josevas72/rf-cc1101-esp32/README.md

# RF CC1101 + ESP32 — placa, firmware ESPHome y caja 3D

Emisor/receptor de radiofrecuencia a **433,92 MHz** con un ESP32 y el módulo **CC1101**
(E07-M1101D), pensado para Home Assistant mediante **ESPHome**. Sirve para controlar por RF
persianas, luces, enchufes o ventiladores con mando, y para escuchar el mando original y mantener
sincronizado el estado.

El repositorio incluye todo lo necesario para reproducirlo: la **placa (PCB)** en KiCad con sus
archivos de fabricación, el **firmware** (plantillas ESPHome) y una **caja imprimible** en 3D.

Hay dos versiones:

- **v2 (recomendada):** placa de **39 × 18 mm** y caja de **48 × 21 × 36,5 mm**. Ver abajo.
- **v1:** la placa original de 58 × 53 mm, con cabecera I2C y caja vertical. Se puede
  descargar tal cual en la etiqueta [`v1.0`](https://github.com/josevas72/rf-cc1101-esp32/releases/tag/v1.0).

<p align="center">
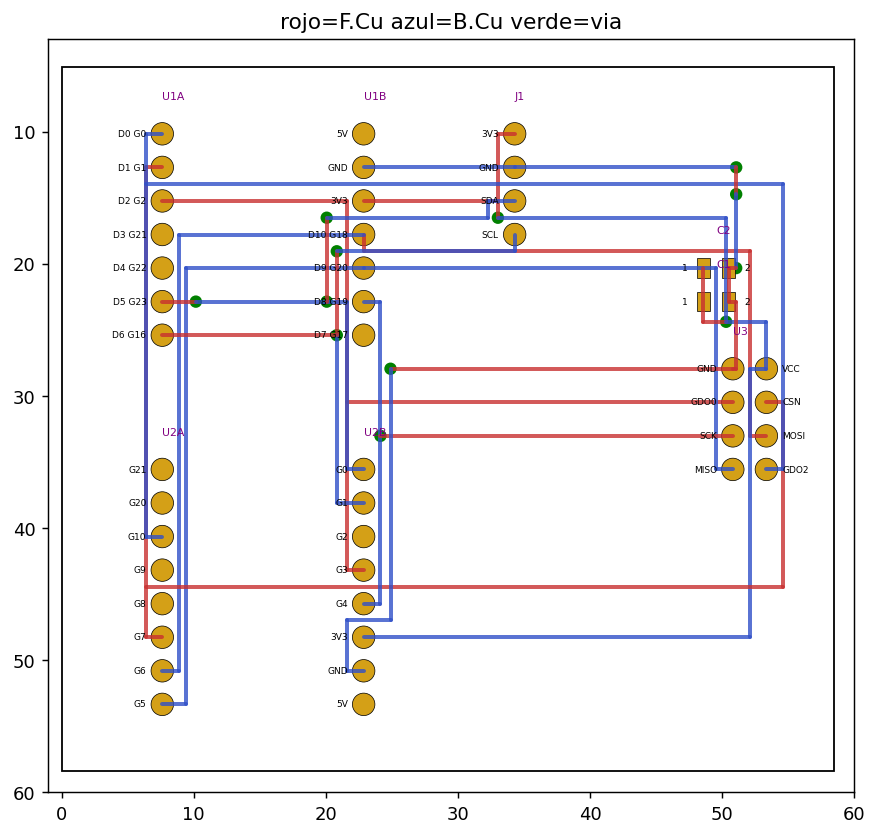
[picture p1: docs/img/pcb_rutado.png]
Rutado de la PCB
  
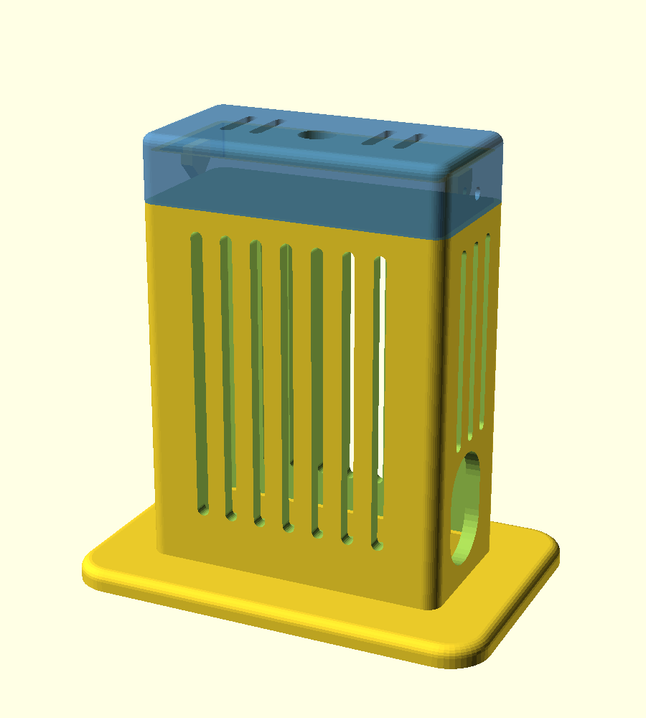
[picture p2: docs/img/caja_v4_montada.png]
Caja 3D montada
  
</p>

## Versión 2: placa pequeña

<p align="center">
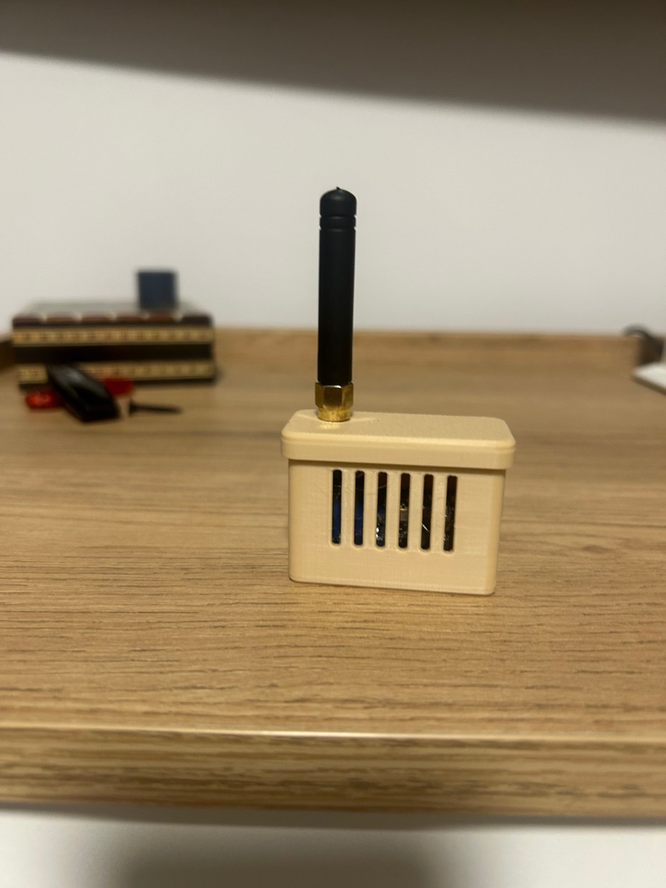
[picture p3: docs/img/v2_frontal.jpg]
Caja v2 con la placa dentro y la antena por la tapa
  
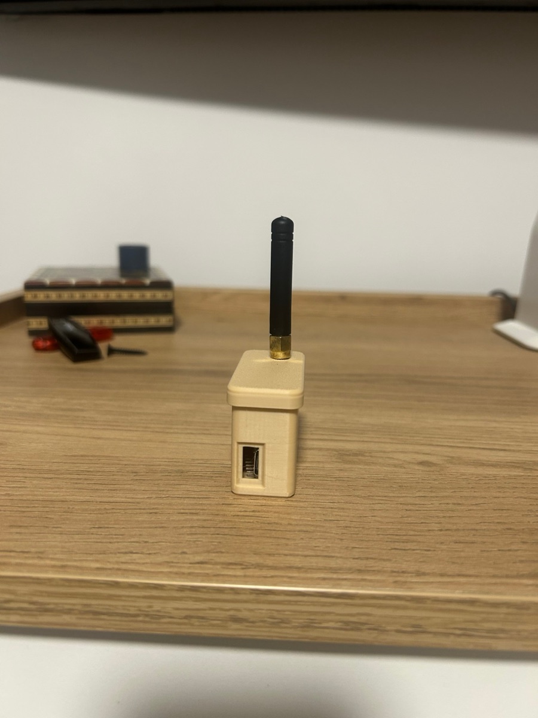
[picture p4: docs/img/v2_lateral_usb.jpg]
Lateral de la caja v2 con el hueco del USB-C
  
</p>
<p align="center">
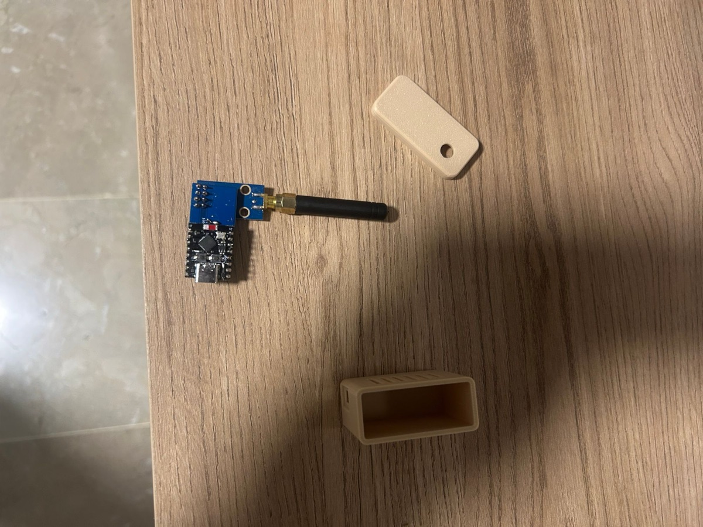
[picture p5: docs/img/v2_piezas.jpg]
Placa v2 montada con el SuperMini y el CC1101, caja y tapa
  
</p>

### Qué cambia respecto a la v1

- Placa de **39,1 × 18,3 mm** (la v1 medía 58,4 × 53,3 mm), 2 capas, 1,6 mm, masa en las dos caras y una sola vía.
- Vista de frente, de izquierda a derecha: **ESP32-C3 SuperMini** en horizontal con el **USB-C por el lateral
  izquierdo**, un **electrolítico de 100 µF** entre 3V3 y GND en medio (pad cuadrado = +) y el zócalo 2×4 del
  **E07-M1101D** con la **antena hacia arriba**.
- Sin GDO2 (emite y recibe por GDO0), sin cabecera I2C y sin los SMD de 10 µF y 100 nF.
- **Los GPIO son los mismos que en la v1**, así que el firmware es prácticamente el mismo.
- Hay otra versión de la misma placa para **XIAO ESP32-C6** (38,1 × 18,3 mm, 2 zócalos 1×7).
  Está diseñada y pasa el DRC, pero **no se ha fabricado todavía**.

| Señal | C3 SuperMini | XIAO ESP32-C6 | E07-M1101D |
|---|---|---|---|
| SCK | GPIO4 | D8 (GPIO19) | 5 |
| MISO | GPIO5 | D9 (GPIO20) | 7 |
| MOSI | GPIO6 | D10 (GPIO18) | 6 |
| CS | GPIO7 | D1 (GPIO1) | 4 |
| GDO0 | GPIO3 | D2 (GPIO2) | 3 |
| 3V3 / GND | 3V3 / GND | 3V3 / GND | 2 / 1 |

<p align="center">
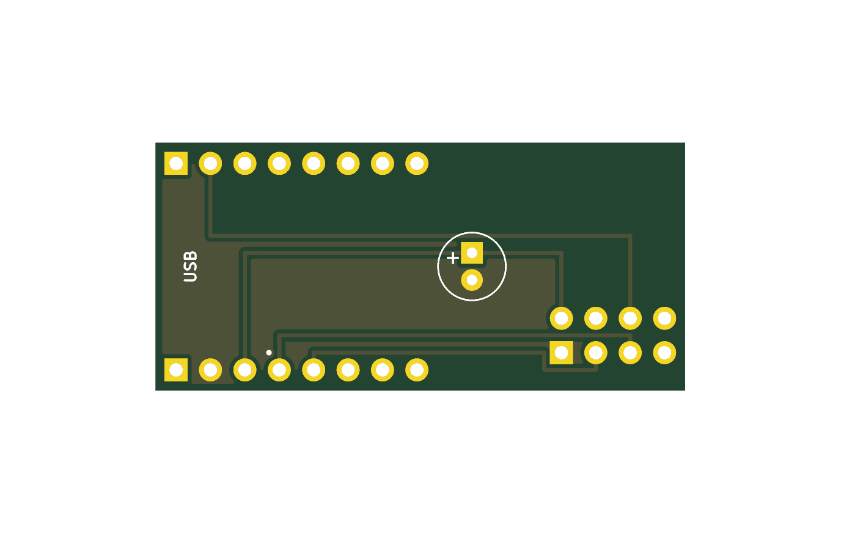
[picture p6: hardware/pcb-v2/img/supermini_delantera.png]
PCB v2, cara delantera
  
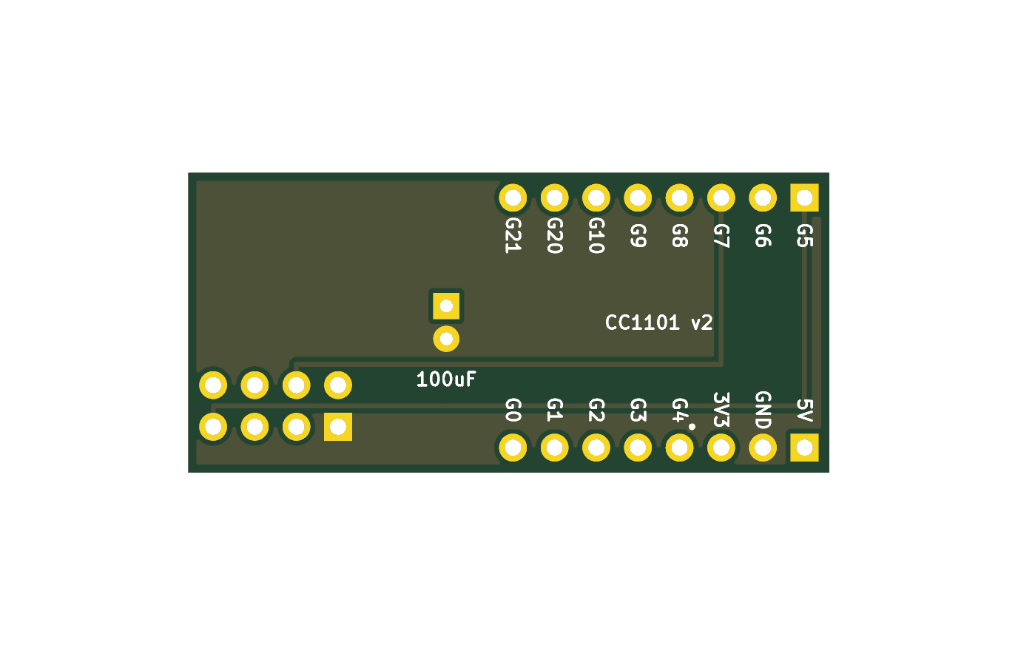
[picture p7: hardware/pcb-v2/img/supermini_trasera.png]
PCB v2, cara trasera
  
</p>

### Materiales (v2)

- ESP32-C3 SuperMini y 2 zócalos hembra 1×8 de 2,54 mm.
- Módulo CC1101 **E07-M1101D** (433 MHz) con antena SMA recta (la de las fotos mide 47 mm) y 1 zócalo hembra 2×4.
- Condensador electrolítico de **100 µF** (Ø5 mm, paso 2 mm). Cualquier altura: no tiene nada encima.

### Fabricación

- SuperMini: sube `hardware/pcb-v2/fabricacion/rf_cc1101_v2_D_PCBWay.zip` a PCBWay o JLCPCB
  (2 capas, 1,6 mm, HASL, agujero mínimo 0,4 mm).
- XIAO C6 (sin probar): `rf_cc1101_v2_XIAO_PCBWay.zip`.
- Proyectos KiCad: `hardware/pcb-v2/kicad/` (SuperMini) y `hardware/pcb-v2/kicad-xiao/`. Si lo modificas,
  pulsa **B** para rellenar las zonas de masa antes del DRC.
- `hardware/pcb-v2/generador/generador_placa_v2.py` es el script en Python que generó el diseño
  (`python3 generador_placa_v2.py <carpeta> D` o `X`). Opcional.

### Caja (v2)

`hardware/caja-v2/` contiene el diseño en **OpenSCAD** (paramétrico) y los STL listos para imprimir.

- Exterior **48 × 21 × 36,5 mm** con la tapa. Interior para un conjunto de 43 × 16 × 32 mm con 0,5 mm de holgura.
- La placa va de pie. La **tuerca del SMA aprieta el módulo contra la tapa** y a la vez cierra la caja: no hace falta
  ningún tornillo.
- La tapa abraza la caja por fuera (ajuste 0,05 mm, probado en PLA). Si te queda floja o dura, cambia `ajuste`
  en el `.scad`.
- Hueco del USB-C con rebaje para la funda del cable, ranuras de ventilación, «RF» grabado en el frente y
  huecos para 4 pies de goma.
- La caja se imprime boca arriba y la tapa boca abajo, las dos sin soportes.
- En el `.scad`, `part = "caja" | "tapa" | "ambas" | "montaje"`.

<p align="center">
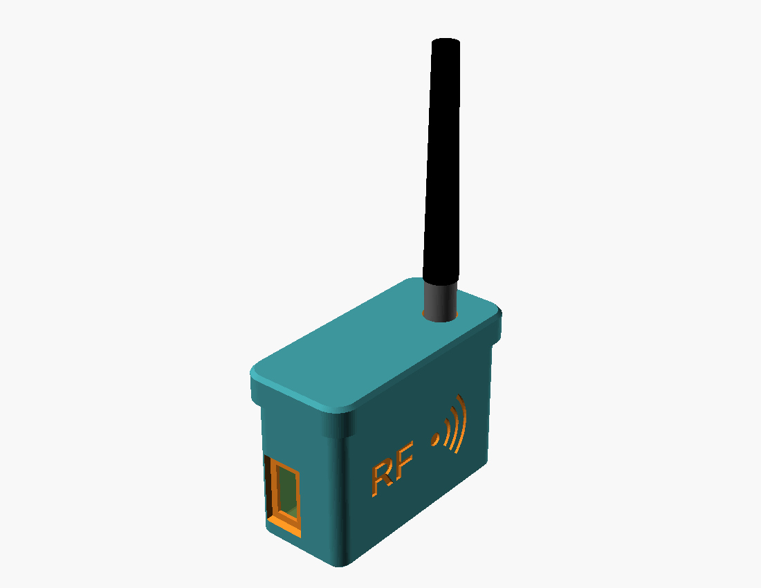
[picture p8: hardware/caja-v2/img/vista_montaje.png]
Vista de montaje de la caja v2 en OpenSCAD
  
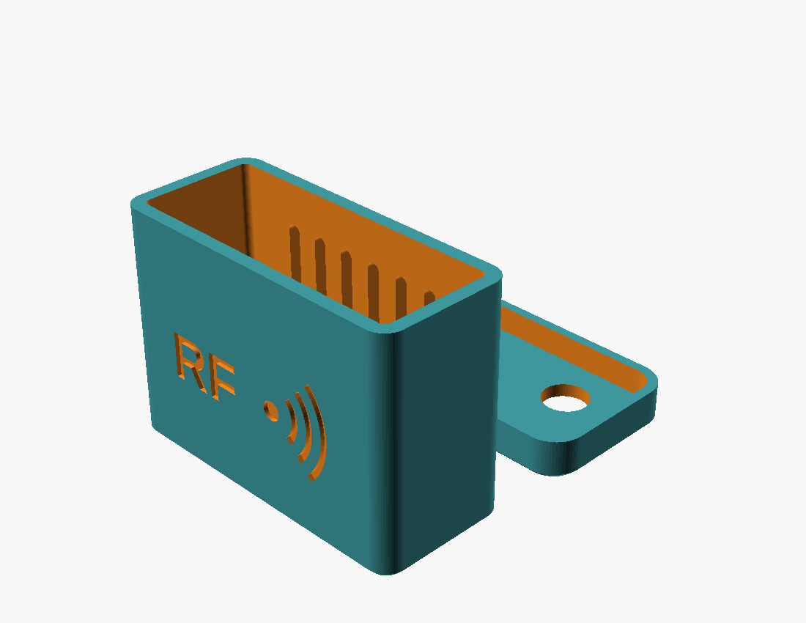
[picture p9: hardware/caja-v2/img/vista_ambas.png]
Caja y tapa v2 en OpenSCAD
  
</p>

### Firmware (v2)

- **SuperMini:** `firmware/esphome/rf-cc1101-v2-c3-supermini.yaml`. Es la plantilla de la v1 sin I2C,
  con la potencia WiFi a 8,5 dBm y un ejemplo nuevo de **ventilador de techo con 6 velocidades** (entidad
  `fan`). Los códigos de los ejemplos son **falsos**: captura los tuyos con `docs/capturar_codigos_rf.md`.
- **XIAO C6:** sirve `firmware/esphome/rf-cc1101-xiao-c6.yaml` de la v1. Borra el bloque `i2c:` si no
  lo usas.

### Lecciones de la v2

1. La WiFi del SuperMini es floja: cerca de un punto de acceso funciona bien, pero a −80 dBm pierde órdenes.
   Colócalo cerca de un punto de acceso o usa el XIAO.
2. Bajar la potencia WiFi a 8,5 dBm hace que la antena del CC1101 se sature menos.
3. Mide el conjunto montado, con el SMA puesto, antes de diseñar la caja: los planos del módulo no bastan.

---

## Versión 1: placa original

## Fotos

<p align="center">
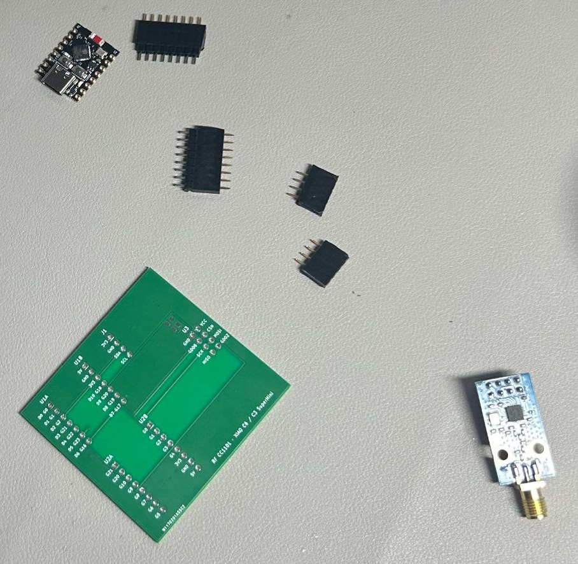
[picture p10: docs/img/componentes_antes_de_soldar.jpg]
Placa recibida y componentes antes de soldar
  
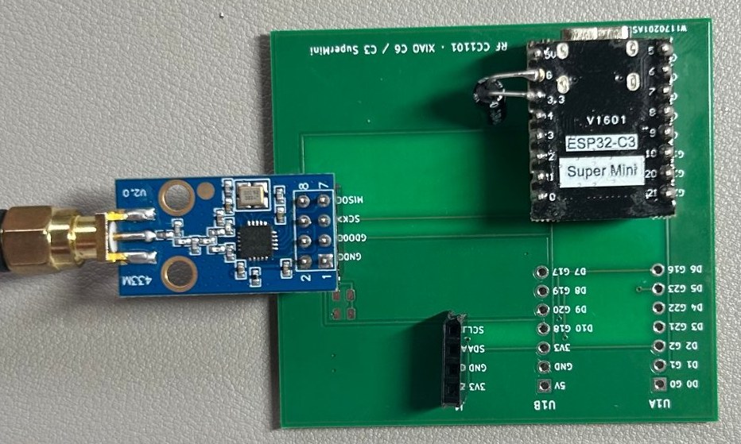
[picture p11: docs/img/placa_prueba_encaje.jpg]
Prueba de encaje del SuperMini y del módulo CC1101
  
</p>
<p align="center">
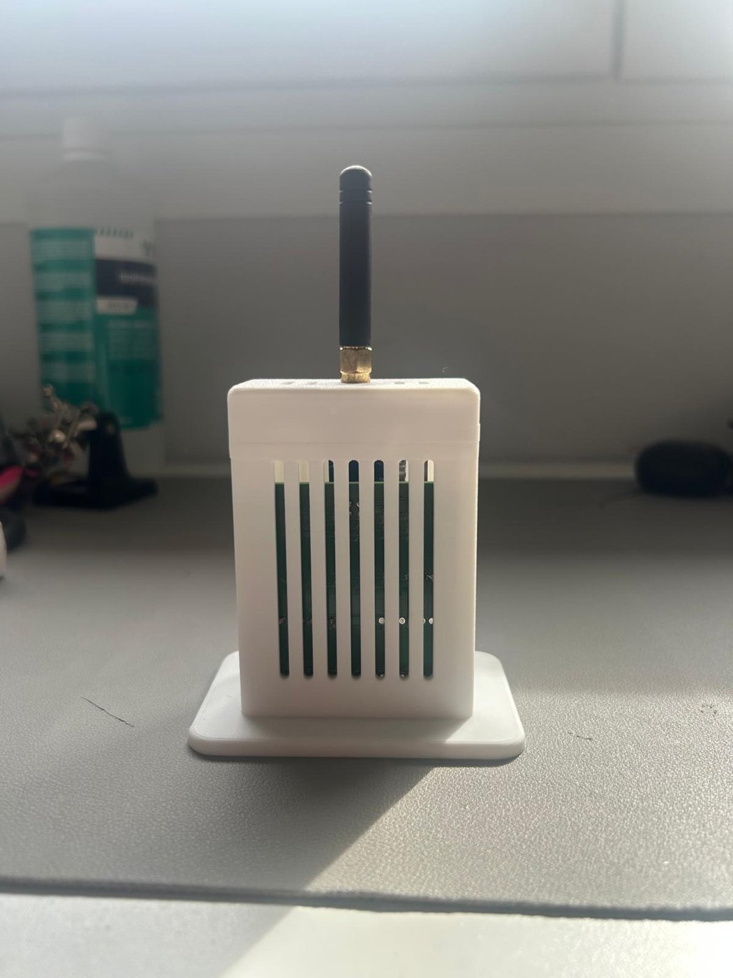
[picture p12: docs/img/caja_prototipo_actual.jpg]
Caja impresa con la placa dentro y la antena fuera
  
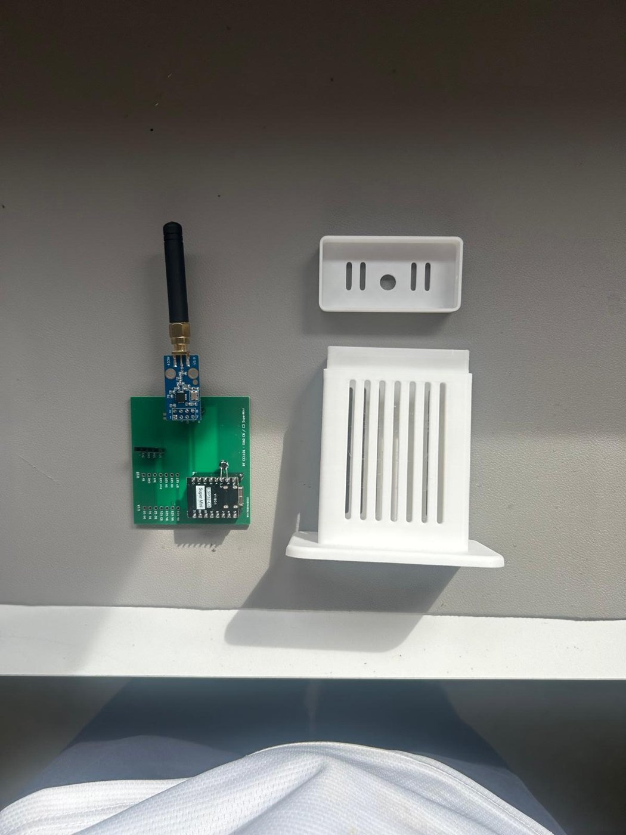
[picture p13: docs/img/piezas_caja_placa.jpg]
Caja, tapa, placa y módulo CC1101 antes de montar
  
</p>

*Arriba: la placa tal como llega de fábrica con los zócalos, el SuperMini y el módulo antes de soldar,
y una primera prueba de encaje. Abajo: la caja impresa con la placa dentro (se ve por las ranuras) y la antena saliendo por la tapa, y las piezas antes de montar.*

## Características

- Placa de 2 capas (58,4 × 53,3 mm) con zócalos para **ESP32-C3 SuperMini** o **XIAO ESP32-C6**
  (se monta uno solo; ver estado de pruebas) y zócalo 2×4 para el módulo **E07-M1101D**.
- Cabecera I2C para un sensor de temperatura (AHT20, BME280, SHT4x…).
- Firmware con el componente nativo `cc1101` de ESPHome, emisión y recepción por un solo pin
  (GDO0) y filtros contra el ruido del receptor.
- **WiFi por portal cautivo**: no hay claves en el código; el dispositivo crea su propia red y
  eliges tu WiFi desde el móvil.
- Caja vertical con peana, tapa tipo caja de zapatos, ventilación, hueco para USB y orificio para
  la antena.

## Estructura del repositorio

```
hardware/
  pcb-v2/             v2: kicad/ (SuperMini), kicad-xiao/, fabricacion/, generador/, img/
  caja-v2/            v2: caja_rf_pequeno.scad, stl/ (caja y tapa), img/
  pcb/                v1:
    kicad/            proyecto KiCad (.kicad_pro, .kicad_pcb, .kicad_sch)
    fabricacion/      ZIP listo para PCBWay/JLCPCB (Gerbers + taladros)
    BOM.csv           lista de materiales
    pcb_rutado.png    vista del rutado
    extras/           script Python que generó el diseño inicial (opcional)
  caja/               v1: caja_rf_cc1101_v4.stl (caja y tapa, listo para imprimir)
firmware/
  esphome/            rf-cc1101-v2-c3-supermini.yaml (v2), rf-cc1101-c3-supermini.yaml y
                      rf-cc1101-xiao-c6.yaml (v1) y secrets.example.yaml
docs/
  capturar_codigos_rf.md   cómo capturar los códigos de un mando
  img/
```

## Hardware

### Conexiones

| Señal | XIAO ESP32-C6 | ESP32-C3 SuperMini |
|---|---|---|
| SCK | GPIO19 (D8) | GPIO4 |
| MISO | GPIO20 (D9) | GPIO5 |
| MOSI | GPIO18 (D10) | GPIO6 |
| CS (CSN) | GPIO1 (D1) | GPIO7 |
| GDO0 | GPIO2 (D2) | GPIO3 |
| GDO2 | GPIO0 (D0) | GPIO10 |
| I2C SDA | GPIO23 (D5) | GPIO0 |
| I2C SCL | GPIO16 (D6) | GPIO1 |

Orden de pines del zócalo del módulo (como el NRF24L01): 1 GND, 2 VCC, 3 GDO0, 4 CSN, 5 SCK,
6 MOSI, 7 MISO, 8 GDO2. El pin 1 lleva el pad cuadrado.

> **Nota XIAO ESP32-C6:** GPIO3 controla el conmutador de antena interno y no sale a ningún pin,
> por eso GDO2 va a GPIO0.

### Lista de materiales

- ESP32-C3 SuperMini **o** XIAO ESP32-C6.
- Módulo CC1101 **E07-M1101D** (433 MHz) con antena SMA.
- Zócalos hembra 2,54 mm: 2 × 1×8 (SuperMini) o 2 × 1×7 (XIAO) y 1 × 2×4.
- Cabecera macho 1×4 para el sensor I2C.
- Condensadores 0805: 10 µF (C1) y 100 nF (C2). Recomendable además un electrolítico de
  100 µF entre 3V3 y GND.
- 2 tornillos M2 × 4 mm autorroscantes (tapa de la caja).

### Fabricación de la PCB

1. Abre `hardware/pcb/kicad/rf_cc1101.kicad_pro` con KiCad 8 o superior.
2. Pulsa **B** para rellenar las zonas de masa y ejecuta el DRC.
3. Para pedirla, sube `hardware/pcb/fabricacion/rf_cc1101_PCBWay.zip` (9 Gerbers y el archivo de
   taladros `.txt`) a tu fabricante. Opciones: 2 capas, 1,6 mm, HASL.

Estado de las pruebas:

- **ESP32-C3 SuperMini:** probado en la PCB, funcionando en producción.
- **XIAO ESP32-C6:** probado y funcionando en producción en un prototipo **cableado a mano**.
  En esta PCB se ha verificado la continuidad de todos los GPIO entre el ESP32-C6 y el CC1101,
  pero **la PCB aún no se ha montado con el XIAO**.

## Firmware (ESPHome)

Necesita **ESPHome 2026.9 o superior**.

1. Elige el archivo de tu placa: `rf-cc1101-c3-supermini.yaml` o `rf-cc1101-xiao-c6.yaml`
   (solo cambian los pines y la placa) y cópialo a tu carpeta de ESPHome.
2. Rellena la sección `substitutions:` del principio (nombre, nombre amistoso, red y **contraseña
   del punto de acceso**). Opcionalmente genera una clave para la API. Compila y graba por USB:
   `esphome run rf-cc1101-c3-supermini.yaml`.
3. Conéctate a la red **RF-CC1101 Config** (se abre el portal; si no, entra en
   `http://192.168.33.1`), elige tu WiFi e introduce la clave.
4. Home Assistant detectará el dispositivo. Si más adelante cambia el router, la red de
   configuración reaparece sola; también puedes mantener 10 s el botón BOOT para restablecer el
   WiFi.

Decisiones de configuración que funcionan bien:

- Pin único GDO0 para emitir y recibir con `cc1101.set_idle` / `begin_tx` / `begin_rx`.
- `filter_bandwidth: 100kHz` y `filter: 150us` en el receptor contra el ruido. Si hay ruido, prueba
  `rx_attenuation`.
- `output_power: 10dBm` en el WiFi del SuperMini para mantener la conexión estable.
- Usar GDO2 como pin de recepción separado recibía bien pero no permitía emitir; se descartó.

Al final de cada YAML hay ejemplos comentados de **persiana** y **ventilador/luz** con `xxxxx` en
lugar de códigos: son los que capturas con tu mando siguiendo `docs/capturar_codigos_rf.md`
(incluye captura de códigos raw y cómo adaptar el protocolo con ayuda de Claude).

## Caja 3D

`hardware/caja/caja_rf_cc1101_v4.stl` incluye caja y tapa, listas para imprimir (158,2 × 54,6 × 83,5 mm):

- Interior útil 54 × 25 × 80 mm, con peana ancha para que no vuelque.
- Placa de pie, antena hacia arriba por la tapa (Ø7 mm) y USB lateral.
- Ventilación por ranuras, nervio y pestañas que retienen la placa.
- Tapa que abraza el labio de la caja, fijada con 2 tornillos M2 × 4 mm laterales.

## Lecciones aprendidas

1. El ruido del receptor con antena puede saturar al ESP32 y tirar el WiFi: se resuelve con los
   filtros del CC1101 y del receptor.
2. En el XIAO ESP32-C6 no se puede usar GPIO3.
3. Los tacos de los tornillos de la tapa deben sobresalir poco para que la placa entre por arriba.

## Licencia

MIT (ver `LICENSE`). Si prefieres una licencia de hardware abierto para la PCB y la caja, por
ejemplo CERN-OHL-P o CC BY-SA 4.0, cámbiala antes de publicar.
