josevas72/rf-cc1101-esp32/hardware/pcb-v2/img/xiao_trasera.png

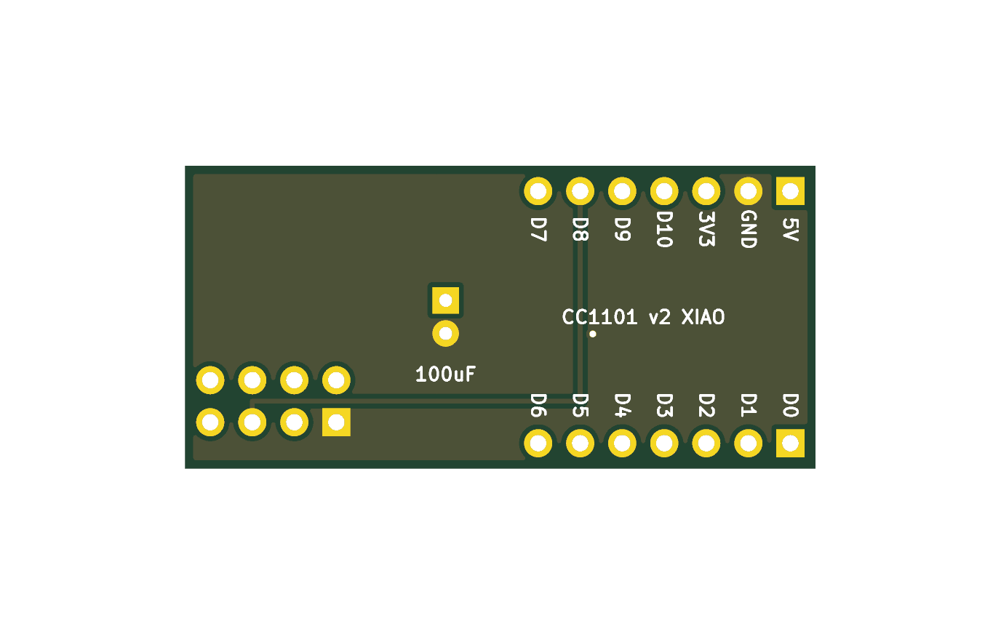
hardware/pcb-v2/img/xiao_trasera.png
