josevas72/rf-cc1101-esp32/hardware/caja-v2/stl/tapa_rf_pequeno.stl

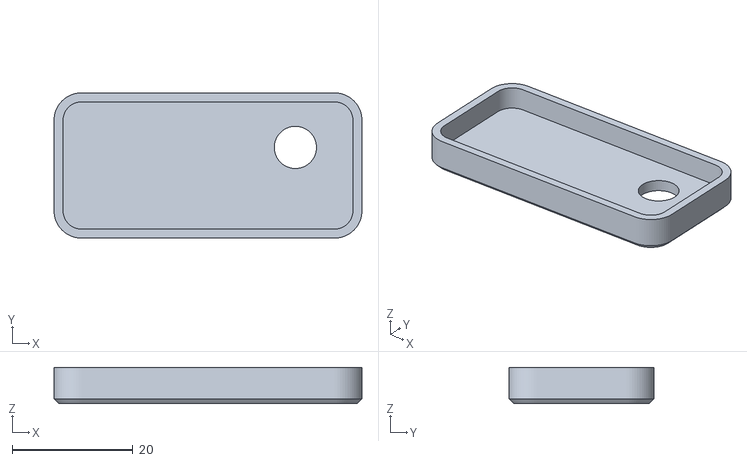
[picture p15: CAD file, 2026-11-11]
hardware/caja-v2/stl/tapa_rf_pequeno.stl
51.1 x 24.1 x 6.00
