josevas72/rf-cc1101-esp32/hardware/caja-v2/stl/caja_rf_pequeno.stl

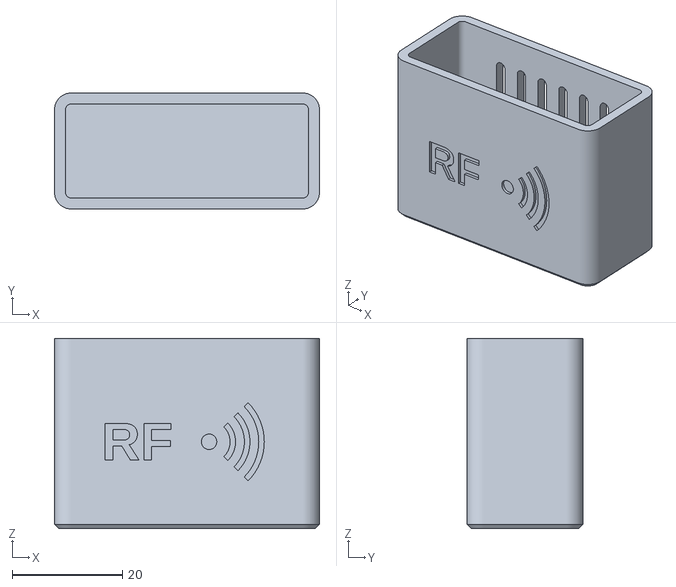
[picture p16: CAD file, 2026-11-11]
hardware/caja-v2/stl/caja_rf_pequeno.stl
48.0 x 21.0 x 34.5
