josevas72/rf-cc1101-esp32/hardware/caja/caja_rf_cc1101_v4.stl

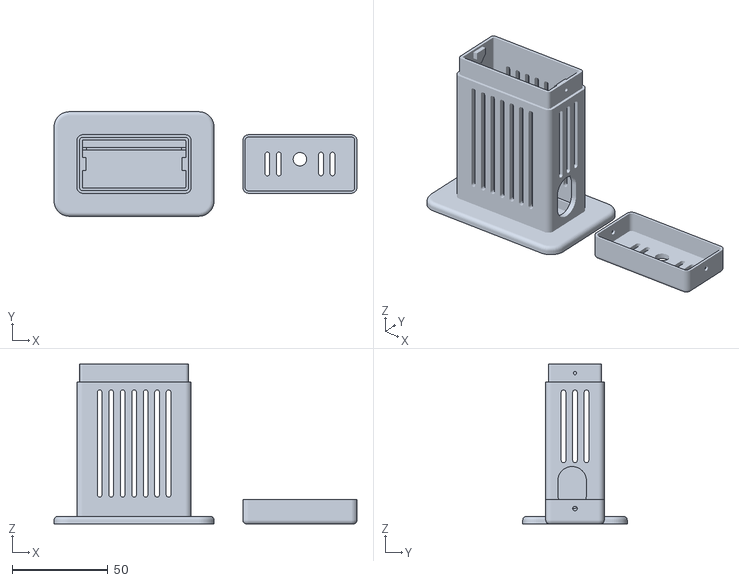
[picture p17: CAD file, 2026-10-20, an earlier design]
hardware/caja/caja_rf_cc1101_v4.stl
158.2 x 54.6 x 83.5
