josevas72/rf-cc1101-esp32/hardware/pcb-v2/kicad-xiao/rf_cc1101_v2.kicad_pcb

## KiCad design hardware/pcb-v2/kicad-xiao/rf_cc1101_v2.kicad_pcb (2026-11-11)

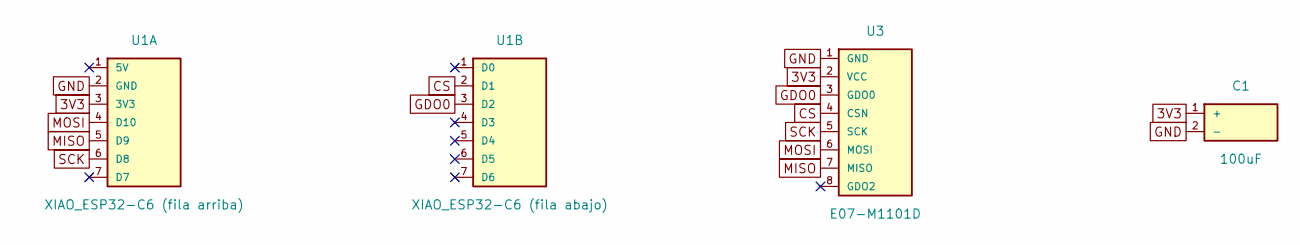
[picture p18: schematic rf_cc1101_v2.kicad_sch]

Parts:
C1: 100uF; CP_Radial_D5.0mm_P2.00mm
U1A: XIAO_ESP32-C6 (fila arriba); PinSocket_1x07_P2.54mm_Vertical
U1B: XIAO_ESP32-C6 (fila abajo); PinSocket_1x07_P2.54mm_Vertical
U3: E07-M1101D; PinSocket_2x04_P2.54mm_Vertical

Connections:
3V3: C1.1 (+), U1A.3 (3V3), U3.2 (VCC)
CS: U1B.2 (D1), U3.4 (CSN)
GDO0: U1B.3 (D2), U3.3 (GDO0)
GND: C1.2 (-), U1A.2 (GND), U3.1 (GND)
MISO: U1A.5 (D9), U3.7 (MISO)
MOSI: U1A.4 (D10), U3.6 (MOSI)
SCK: U1A.6 (D8), U3.5 (SCK)

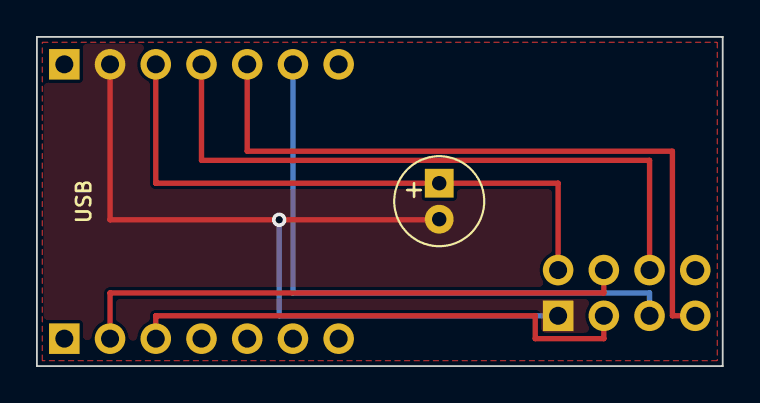
[picture p19: board hardware/pcb-v2/kicad-xiao/rf_cc1101_v2.kicad_pcb from above]

Board: 2 copper layers, 38.1 x 18.3 mm, 4 parts (0 on the bottom side), 7 nets.
