josevas72/rf-cc1101-esp32/hardware/pcb-v2/kicad/rf_cc1101_v2.kicad_pcb

## KiCad design hardware/pcb-v2/kicad/rf_cc1101_v2.kicad_pcb (2026-11-11)

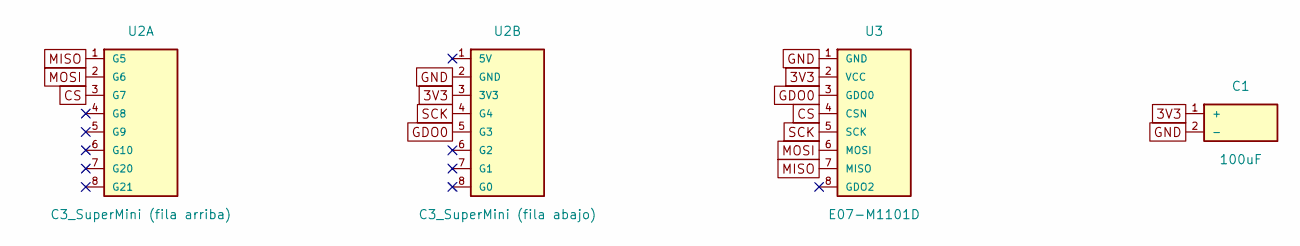
[picture p20: schematic rf_cc1101_v2.kicad_sch]

Parts:
C1: 100uF; CP_Radial_D5.0mm_P2.00mm
U2A: C3_SuperMini (fila arriba); PinSocket_1x08_P2.54mm_Vertical
U2B: C3_SuperMini (fila abajo); PinSocket_1x08_P2.54mm_Vertical
U3: E07-M1101D; PinSocket_2x04_P2.54mm_Vertical

Connections:
3V3: C1.1 (+), U2B.3 (3V3), U3.2 (VCC)
CS: U2A.3 (G7), U3.4 (CSN)
GDO0: U2B.5 (G3), U3.3 (GDO0)
GND: C1.2 (-), U2B.2 (GND), U3.1 (GND)
MISO: U2A.1 (G5), U3.7 (MISO)
MOSI: U2A.2 (G6), U3.6 (MOSI)
SCK: U2B.4 (G4), U3.5 (SCK)

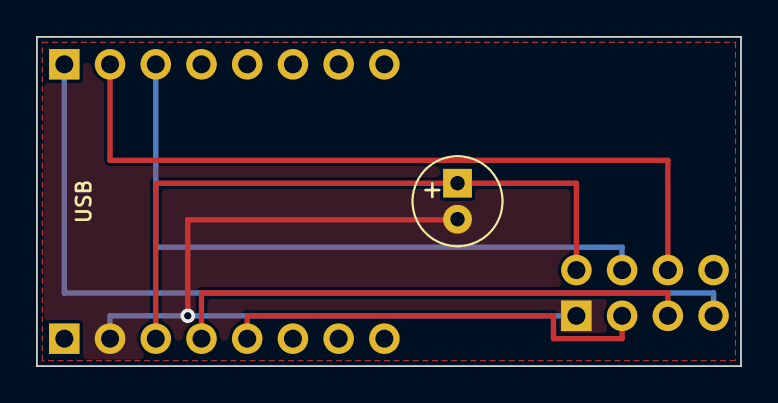
[picture p21: board hardware/pcb-v2/kicad/rf_cc1101_v2.kicad_pcb from above]

Board: 2 copper layers, 39.1 x 18.3 mm, 4 parts (0 on the bottom side), 7 nets.
