josevas72/rf-cc1101-esp32/hardware/pcb/kicad/rf_cc1101.kicad_pcb

## KiCad design hardware/pcb/kicad/rf_cc1101.kicad_pcb (2026-10-20, an earlier design)

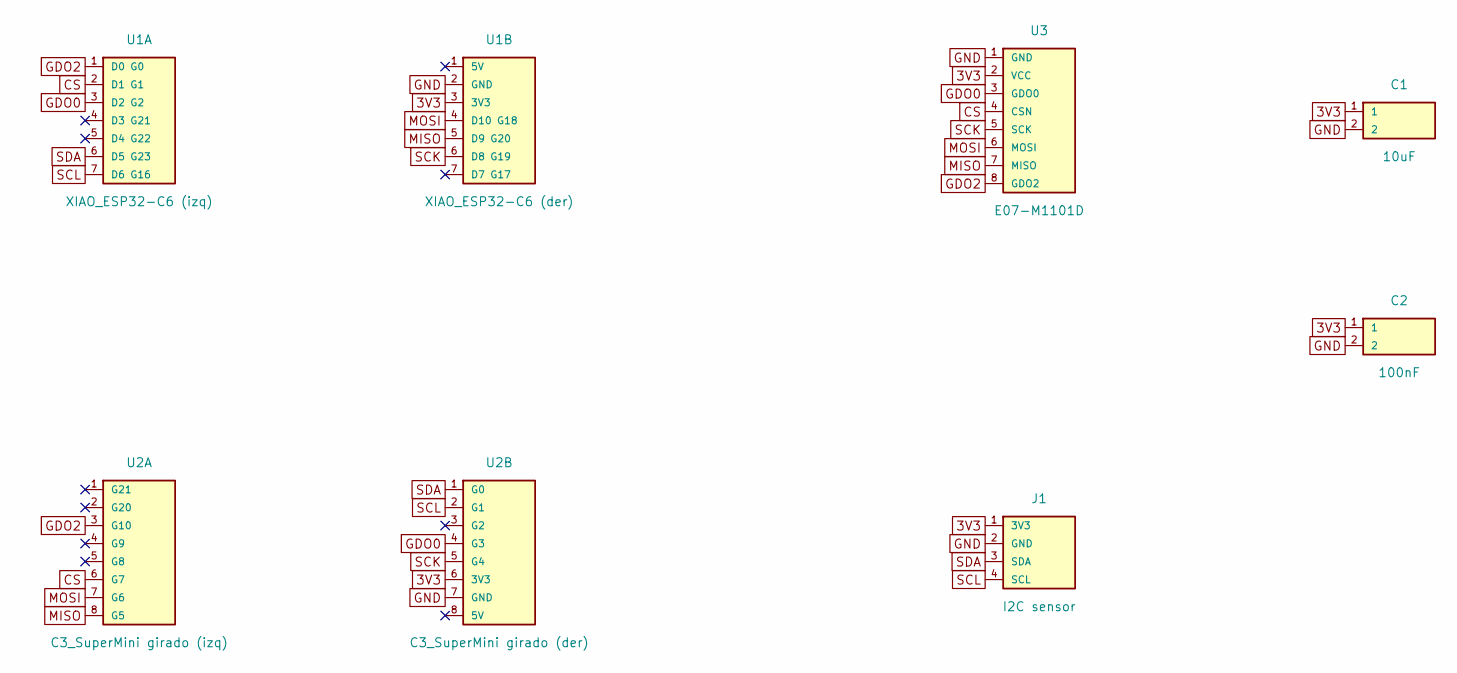
[picture p22: schematic rf_cc1101.kicad_sch]

Parts:
C1: 10uF; C_0805_2012Metric
C2: 100nF; C_0805_2012Metric
J1: I2C sensor; PinHeader_1x04_P2.54mm_Vertical
U1A: XIAO_ESP32-C6 (izq); PinSocket_1x07_P2.54mm_Vertical
U1B: XIAO_ESP32-C6 (der); PinSocket_1x07_P2.54mm_Vertical
U2A: C3_SuperMini girado (izq); PinSocket_1x08_P2.54mm_Vertical
U2B: C3_SuperMini girado (der); PinSocket_1x08_P2.54mm_Vertical
U3: E07-M1101D; PinSocket_2x04_P2.54mm_Vertical

Connections:
3V3: C1.1, C2.1, J1.1 (3V3), U1B.3 (3V3), U2B.6 (3V3), U3.2 (VCC)
CS: U1A.2 (D1 G1), U2A.6 (G7), U3.4 (CSN)
GDO0: U1A.3 (D2 G2), U2B.4 (G3), U3.3 (GDO0)
GDO2: U1A.1 (D0 G0), U2A.3 (G10), U3.8 (GDO2)
GND: C1.2, C2.2, J1.2 (GND), U1B.2 (GND), U2B.7 (GND), U3.1 (GND)
MISO: U1B.5 (D9 G20), U2A.8 (G5), U3.7 (MISO)
MOSI: U1B.4 (D10 G18), U2A.7 (G6), U3.6 (MOSI)
SCK: U1B.6 (D8 G19), U2B.5 (G4), U3.5 (SCK)
SCL: J1.4 (SCL), U1A.7 (D6 G16), U2B.2 (G1)
SDA: J1.3 (SDA), U1A.6 (D5 G23), U2B.1 (G0)

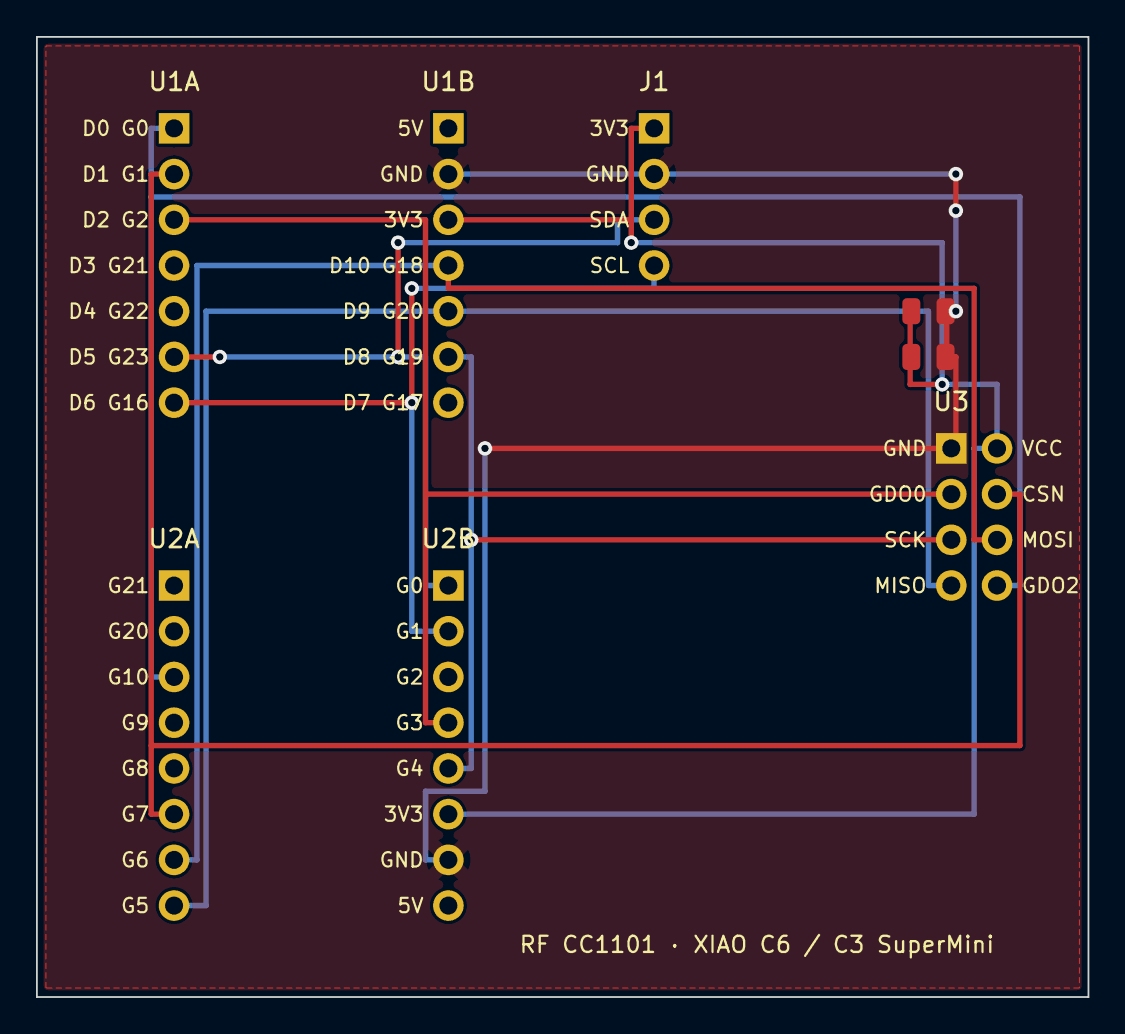
[picture p23: board rf_cc1101.kicad_pcb from above]

Board: 2 copper layers, 58.4 x 53.3 mm, 8 parts (0 on the bottom side), 10 nets.
