josevas72/rf-cc1101-esp32/(commit log)

2026-10-20 Primera version
    [BOM.csv, caja_rf_cc1101_v4.stl, rf_cc1101.kicad_pcb, rf_cc1101.kicad_sch]
2026-11-11 Versión 2: placa pequeña 39 x 18 mm y caja de 48 x 21 x 36,5 mm
    - hardware/pcb-v2: KiCad de la placa v2 para ESP32-C3 SuperMini (fabricada
    y probada) y para XIAO ESP32-C6 (sin fabricar), ZIP para PCBWay,
    generador en Python y renders.
    - hardware/caja-v2: caja OpenSCAD paramétrica, STL de caja y tapa, vistas.
    - firmware: plantilla rf-cc1101-v2-c3-supermini.yaml (sin I2C, WiFi a
    8,5 dBm, ejemplo de ventilador de 6 velocidades con códigos falsos).
    - README: sección v2 con fotos; la v1 queda debajo y en la etiqueta v1.0.
    - docs/capturar_codigos_rf.md: el código de ejemplo pasa a ser falso.
    [caja_rf_pequeno.scad, caja_rf_pequeno.stl, rf_cc1101_v2.kicad_pcb, rf_cc1101_v2.kicad_sch, tapa_rf_pequeno.stl]
